SinTh0r4s/WifiOsziSensor/src/dma_esp32.cpp

#ifdef ESP32

// local includes
#include "dma.h"


void mDMA::init()
{
    
}

uint8_t* mDMA::getLastCompletedBuffer()
{
    return nullptr;
}

void mDMA::start()
{

}

void mDMA::suspend()
{

}

void mDMA::triggerHit()
{

}

void mDMA::resume()
{

}

void mDMA::handleEvents()
{
    
}


#endif  // ESP32
