SinTh0r4s/WifiOsziSensor/(commit log)

2020-11-30 commited current state
2020-11-30 reworked for 8bit resolution. DMA currently not working
2020-12-04 reworked to single sample window only
2020-12-20 refactored driver into source folder such that the project is easier set up
2020-12-21 Rollback to older driver to fit older firmware
2020-12-22 Bugfix. Now sends and receives raw wifi, but windoof cannot match it. Gotta go back to udp :-(
    [main.cpp]
2020-12-22 updated WINC driver
2020-12-22 refactored back to arduino lib WiFi101
2020-12-22 Added cute SOS morsing on error
    [debug.h, main.cpp]
2020-12-22 added draft for UDP socket. TMP
2020-12-23 bugfix and added legWarning
    [debug.h]
2020-12-23 Implemented network side for sample transmission
2020-12-23 added old code for integrated adc. Reacts not as expected. Can sample on demand via UDP
2020-12-26 fixed unset packet data. Network now works with the python frontend
    [network.cpp]
2020-12-27 added uid to sample transmissions
2020-12-27 removed sample time
2021-01-03 get the adc to run mostly continuously
2021-01-15 Added missing pragma once
    [dma.h]
2021-01-16 prepped for additional esp32 code
2021-01-17 Added esp32 support and sensor sampling
2021-01-18 added CS to global config and switched to VSPI
2021-01-27 back down to 666kHz cause SPI problems :-(
    [adc_esp32.cpp]
2021-01-29 layout and missing include
    [adc_esp32.cpp, adc_mkr1000.cpp, constants.h, debug.h, dma_esp32.cpp, main.cpp]
